gztproject/GO-button/PCB/GO-button/GO-button-QFN44.png

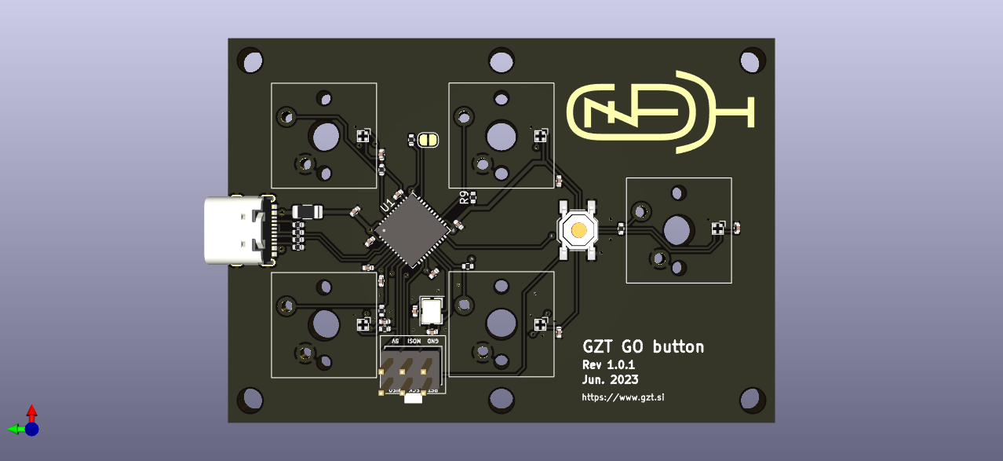
PCB/GO-button/GO-button-QFN44.png
