gztproject/GO-button/README.md

# GO-button



A programmable 5-button RGB macro keypad
