gztproject/GO-button/docs/index.rst

.. GZT-GO documentation master file, created by
   sphinx-quickstart on Mon Jan 22 09:24:08 2024.
   You can adapt this file completely to your liking, but it should at least
   contain the root `toctree` directive.

GZT-GO Button Documentation
==================================

.. toctree::
   :maxdepth: 3
   :caption: Contents:
   
   manual
   updating
   serialApi
   codelists
   changelog
