gztproject/GO-button/3D/v2/Go-Button-BoxTop_V2.3mf

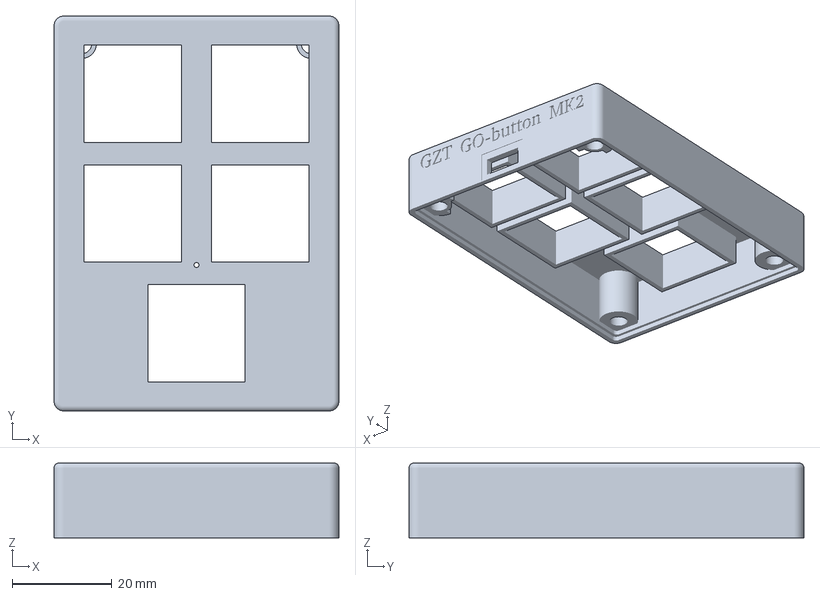
[picture p2: CAD file, 2026-03-15]
3D/v2/Go-Button-BoxTop_V2.3mf
57.0 x 79.0 x 15.0 mm
