gztproject/GO-button/3D/v2/Go-Button-DrillJigJig.3mf

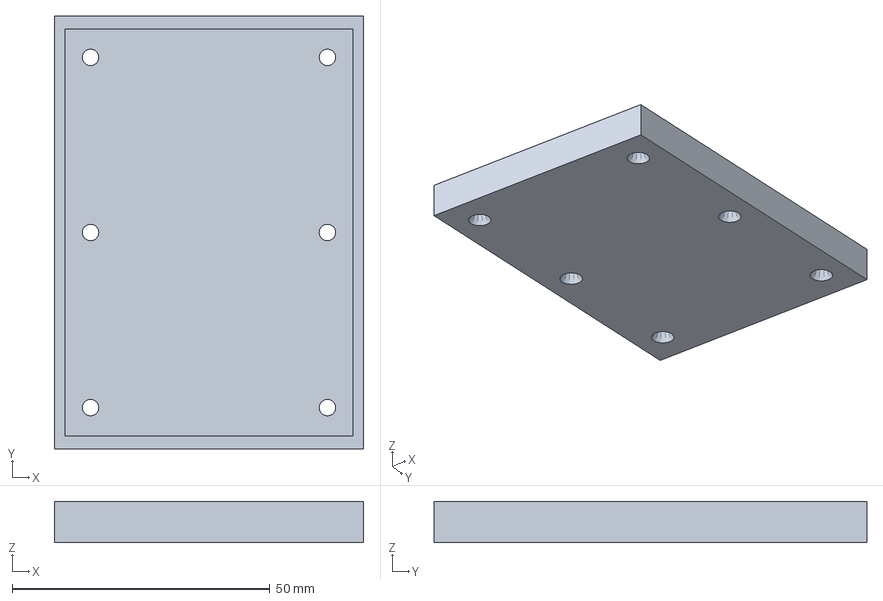
[picture p3: CAD file, 2026-03-15]
3D/v2/Go-Button-DrillJigJig.3mf
60.0 x 84.0 x 8.00 mm
