gztproject/GO-button/3D/v2/Go-Button-DrillJigCut001.3mf

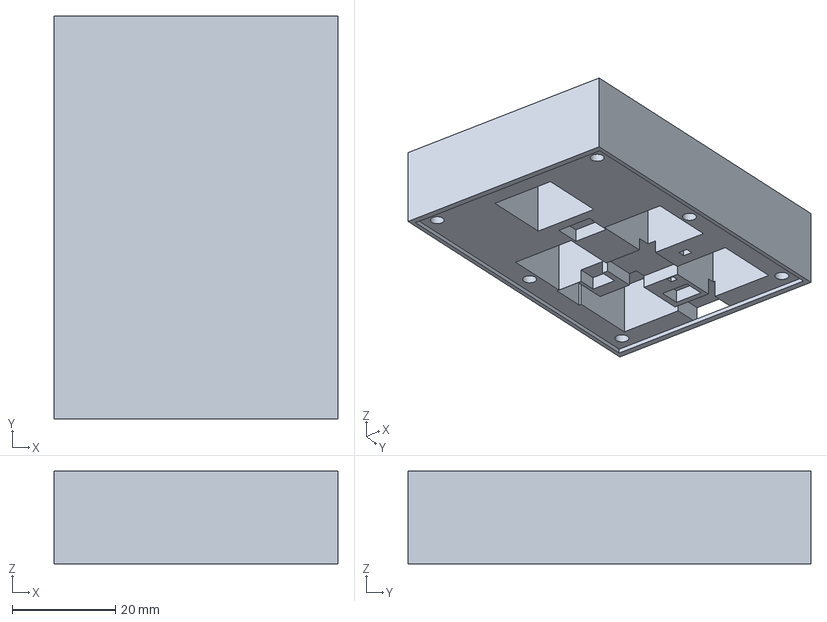
[picture p4: CAD file, 2026-03-15]
3D/v2/Go-Button-DrillJigCut001.3mf
55.0 x 78.0 x 18.0 mm
