gztproject/GO-button/3D/v2/Go-Button-BoxBottom_V2.3mf

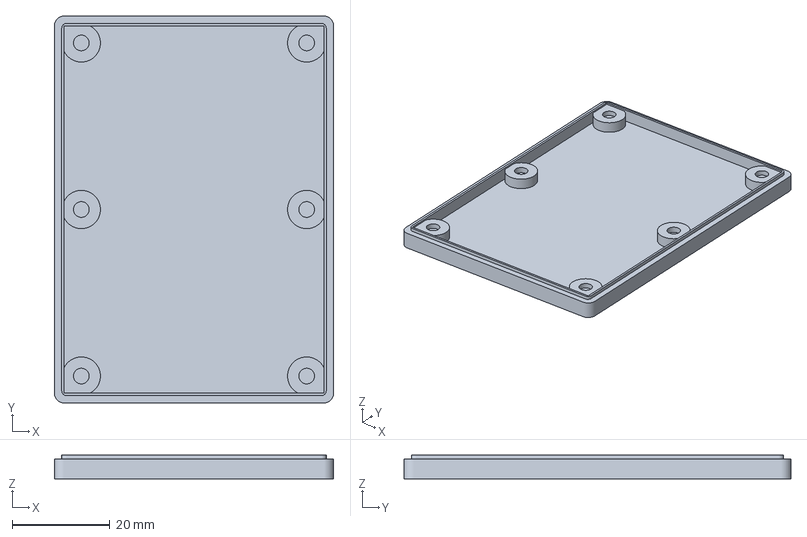
[picture p5: CAD file, 2026-03-15]
3D/v2/Go-Button-BoxBottom_V2.3mf
57.0 x 79.0 x 4.80 mm
