gztproject/GO-button/3D/v2/Go-Button-Box_V2.3mf

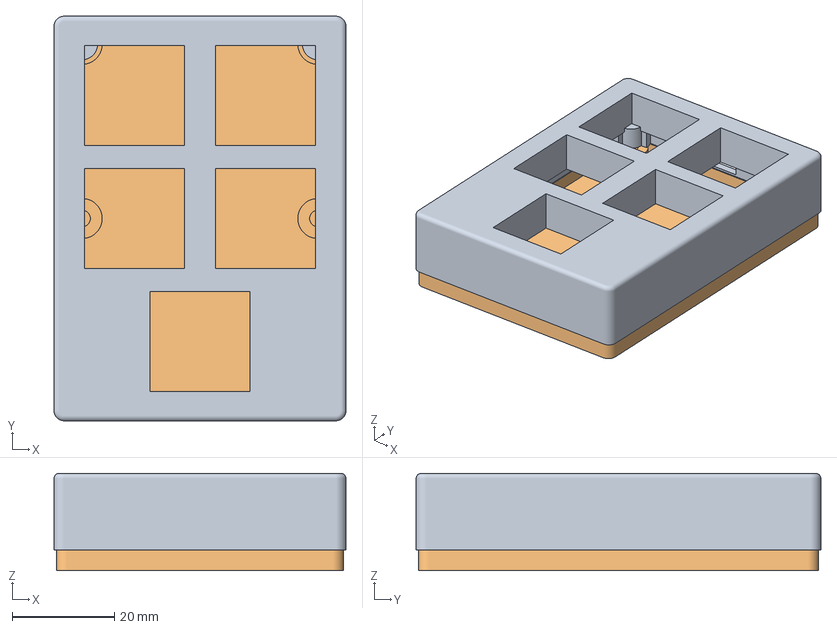
[picture p6: CAD file, 2026-03-15]
3D/v2/Go-Button-Box_V2.3mf
57.0 x 79.0 x 19.0 mm
