gztproject/GO-button/3D/v2/Go-Button-SolderingJig.stl

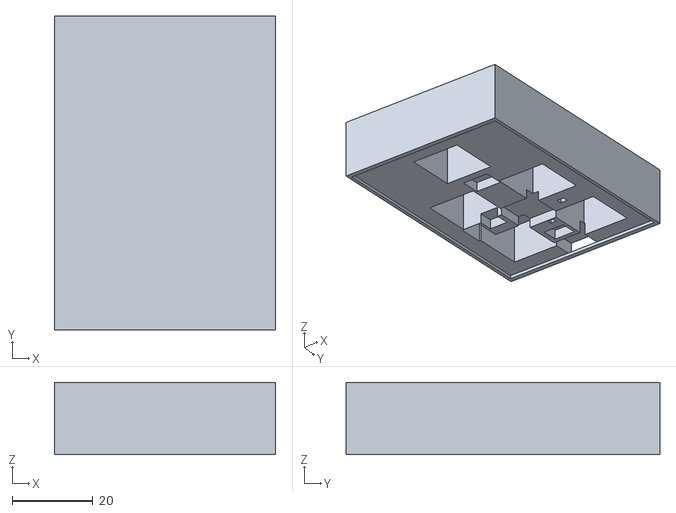
[picture p7: CAD file, 2024-02-04]
3D/v2/Go-Button-SolderingJig.stl
55.0 x 78.0 x 18.0
