gztproject/GO-button/3D/v2/DSA 1u.step

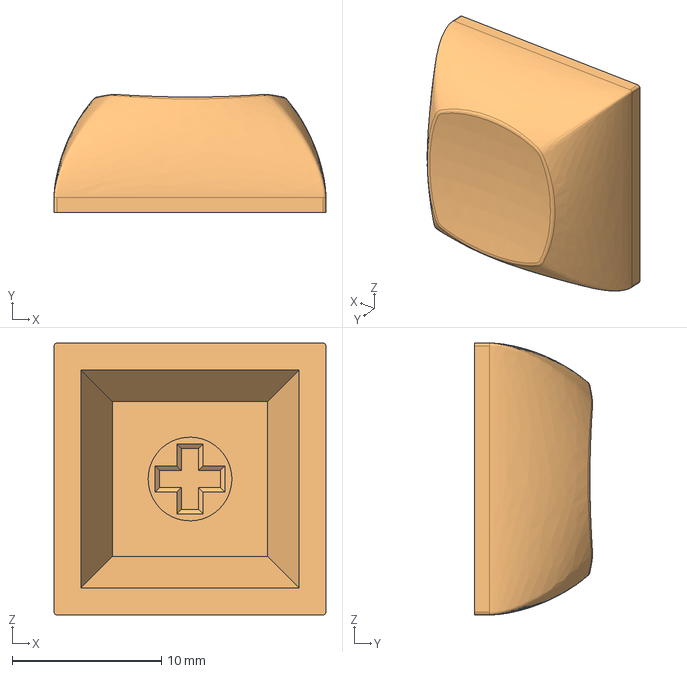
[picture p8: CAD file, 2023-05-16]
3D/v2/DSA 1u.step
18.2 x 7.91 x 18.2 mm
