gztproject/GO-button/3D/v1/Go-Button.FCStd

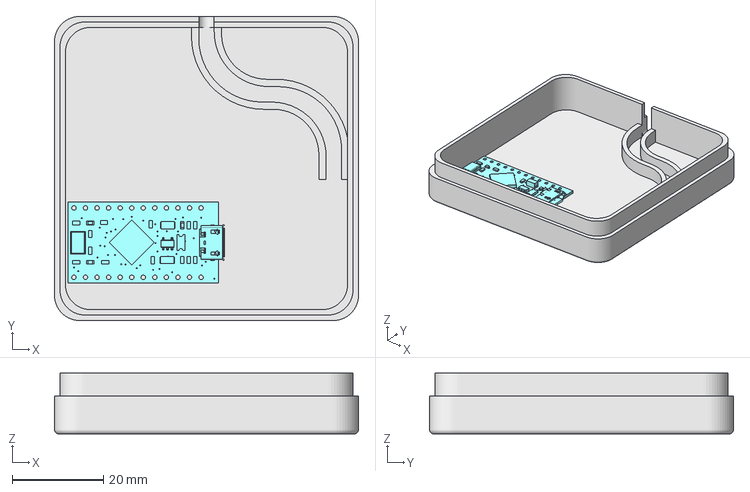
[picture p9: CAD file, 2023-05-16, an earlier design]
3D/v1/Go-Button.FCStd
66.8 x 66.8 x 13.4 mm
Pro_Micro
