gztproject/GO-button/3D/v1/Go-Button-Bottom.stl

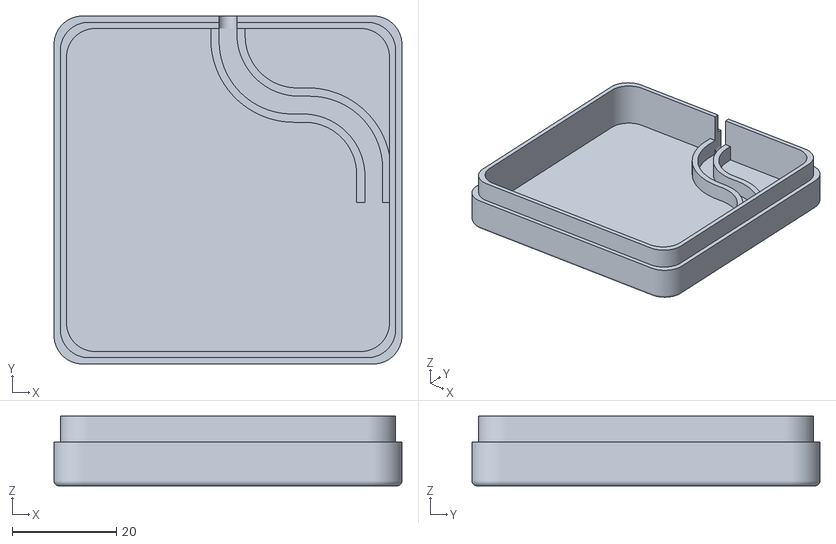
[picture p10: CAD file, 2023-05-16, an earlier design]
3D/v1/Go-Button-Bottom.stl
66.8 x 66.8 x 13.4
