gztproject/GO-button/3D/v1/Go-Button-Top.stl

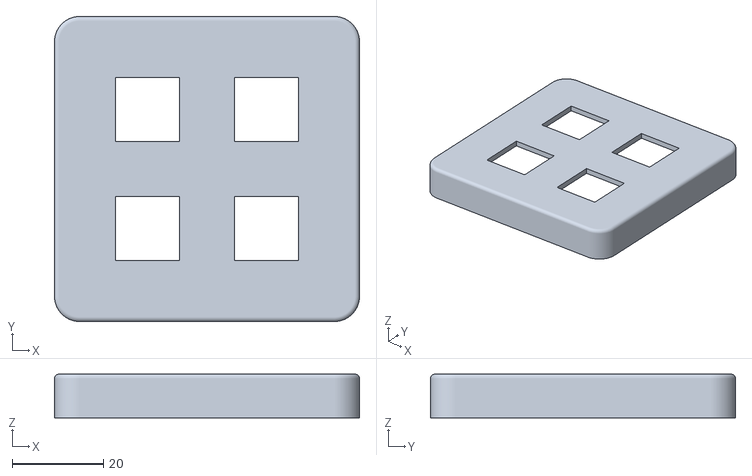
[picture p11: CAD file, 2023-05-16, an earlier design]
3D/v1/Go-Button-Top.stl
66.8 x 66.8 x 9.60
