gztproject/GO-button/3D/v2/Go-Button-BoxBottom.3mf

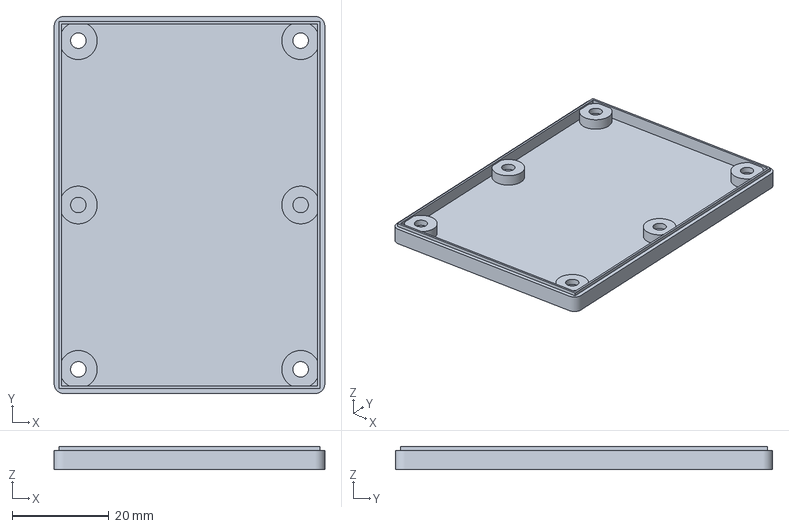
[picture p12: CAD file, 2023-05-16, an earlier design]
3D/v2/Go-Button-BoxBottom.3mf
56.0 x 78.0 x 4.80 mm
