gztproject/GO-button/3D/v2/Go-Button-BoxTop.3mf

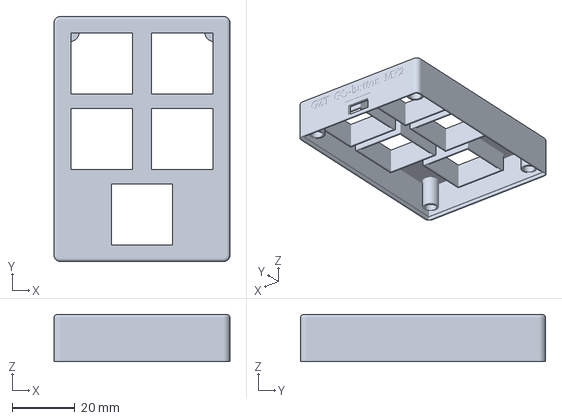
[picture p13: CAD file, 2023-05-16, an earlier design]
3D/v2/Go-Button-BoxTop.3mf
56.0 x 78.0 x 15.0 mm
