gztproject/GO-button/(list of files, cad)

Other CAD files:
3D/v2/Go-Button.FCStd
3D/v2/Go-Button-SolderingJigCut.amf
