gztproject/GO-button/docs/changelog.rst

.. _changelog:

#########################
Changelog
#########################

2.1.X
=========================

Migrating to this version requires factory resetting the device due to changes in data structure.

.. _V-2-1-1:

2.1.1 (2024-02-14)
---------------------------------------------------------------------------

:download:`firmware-2.1.1.hex <_static/firmware-2.1.1.hex>`

- Fixed default preset not being applied in the same restart

.. _V-2-1-0:

2.1.0 (2024-02-11)
---------------------------------------------------------------------------

:download:`firmware-2.1.0.hex <_static/firmware-2.1.0.hex>`

- Major code cleanup
- Serial API
- Separate reset and set default preset chords
- Added OFF preset
- Documentation

.. _V-2-0-0:

2.0.0 (2023)
=========================

- Settings saved in EEPROM
- C++ objects

.. _V-1-0-0:

1.0.0
=========================

- FIrst POC version
