gztproject/GO-button/PCB/GO-button/GO-button-QFN44.kicad_pcb

## KiCad design PCB/GO-button/GO-button-QFN44.kicad_pcb (2023-06-17)

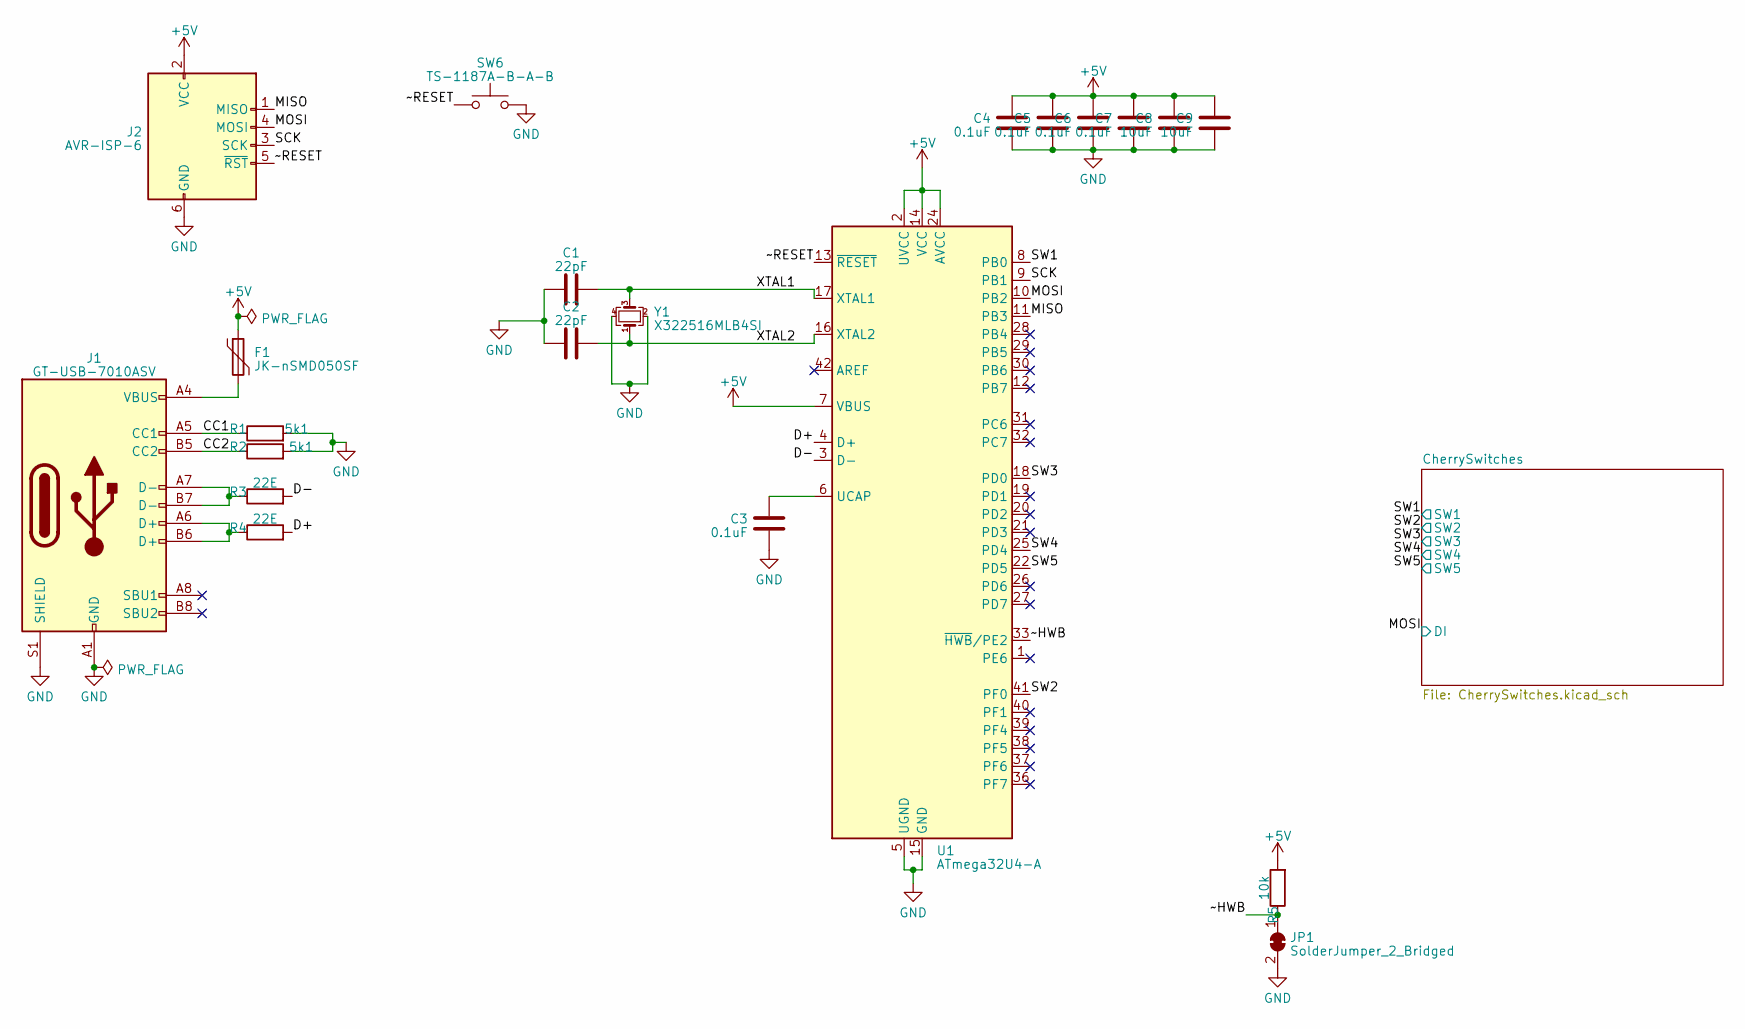
[picture p14: schematic GO-button-QFN44.kicad_sch, GO-button]

Parts:
C1, C2: 22pF; C_0402_1005Metric
C3, C4, C5, C6, C7: 0.1uF; C_0402_1005Metric
C8, C9: 10uF; C_0402_1005Metric
F1: JK-nSMD050SF; Fuse_1206_3216Metric
J1: GT-USB-7010ASV; USB_C_Receptacle_G-Switch_GT-USB-7010ASV
J2: AVR-ISP-6; AVR_ISP_HEADER
JP1: SolderJumper_2_Bridged; SolderJumper-2_P1.3mm_Bridged_RoundedPad1.0x1.5mm
R1, R2: 5k1; R_0402_1005Metric
R3, R4: 22E; R_0402_1005Metric
R5: 10k; R_0402_1005Metric
SW6: TS-1187A-B-A-B; SW_SPST_TL3342
U1: ATmega32U4-A; QFN-44-1EP_7x7mm_P0.5mm_EP5.2x5.2mm_ThermalVias
Y1: X322516MLB4SI; Crystal_SMD_3225-4Pin_3.2x2.5mm

Connections:
+5V: C4.2, C5.2, C6.2, C7.2, C8.2, C9.2, F1.1, J2.2 (VCC), R5.2, U1.2 (UVCC), U1.7 (VBUS), U1.14 (VCC), U1.24 (AVCC), U1.34 (VCC), U1.44 (AVCC); also elsewhere on the board
/CC1: J1.A5 (CC1), R1.1
/CC2: J1.B5 (CC2), R2.1
/D+: R4.2, U1.4 (D+)
/D-: R3.2, U1.3 (D-)
/MISO: J2.1 (MISO), U1.11 (PB3)
/MOSI: J2.4 (MOSI), U1.10 (PB2); also elsewhere on the board
/SCK: J2.3 (SCK), U1.9 (PB1)
/SW1: U1.8 (PB0); also elsewhere on the board
/SW2: U1.41 (PF0); also elsewhere on the board
/SW3: U1.18 (PD0); also elsewhere on the board
/SW4: U1.25 (PD4); also elsewhere on the board
/SW5: U1.22 (PD5); also elsewhere on the board
/XTAL1: C1.2, U1.17 (XTAL1), Y1.3
/XTAL2: C2.2, U1.16 (XTAL2), Y1.1
/~HWB: JP1.1 (A), R5.1, U1.33 (~HWB/PE2)
/~RESET: J2.5 (~RST), SW6.1, U1.13 (~RESET)
GND: C1.1, C2.1, C3.1, C4.1, C5.1, C6.1, C7.1, C8.1, C9.1, J1.A1 (GND), J1.A12 (GND), J1.B1 (GND), J1.B12 (GND), J1.S1 (SHIELD), J2.6 (GND), JP1.2 (B), R1.2, R2.2, SW6.2, U1.5 (UGND), U1.15 (GND), U1.23 (GND), U1.35 (GND), U1.43 (GND), Y1.2, Y1.4; also elsewhere on the board
unnamed: F1.2, J1.A4 (VBUS), J1.A9 (VBUS), J1.B4 (VBUS), J1.B9 (VBUS)
unnamed: J1.A6 (D+), J1.B6 (D+), R4.1
unnamed: J1.A7 (D-), J1.B7 (D-), R3.1
unnamed: C3.2, U1.6 (UCAP)

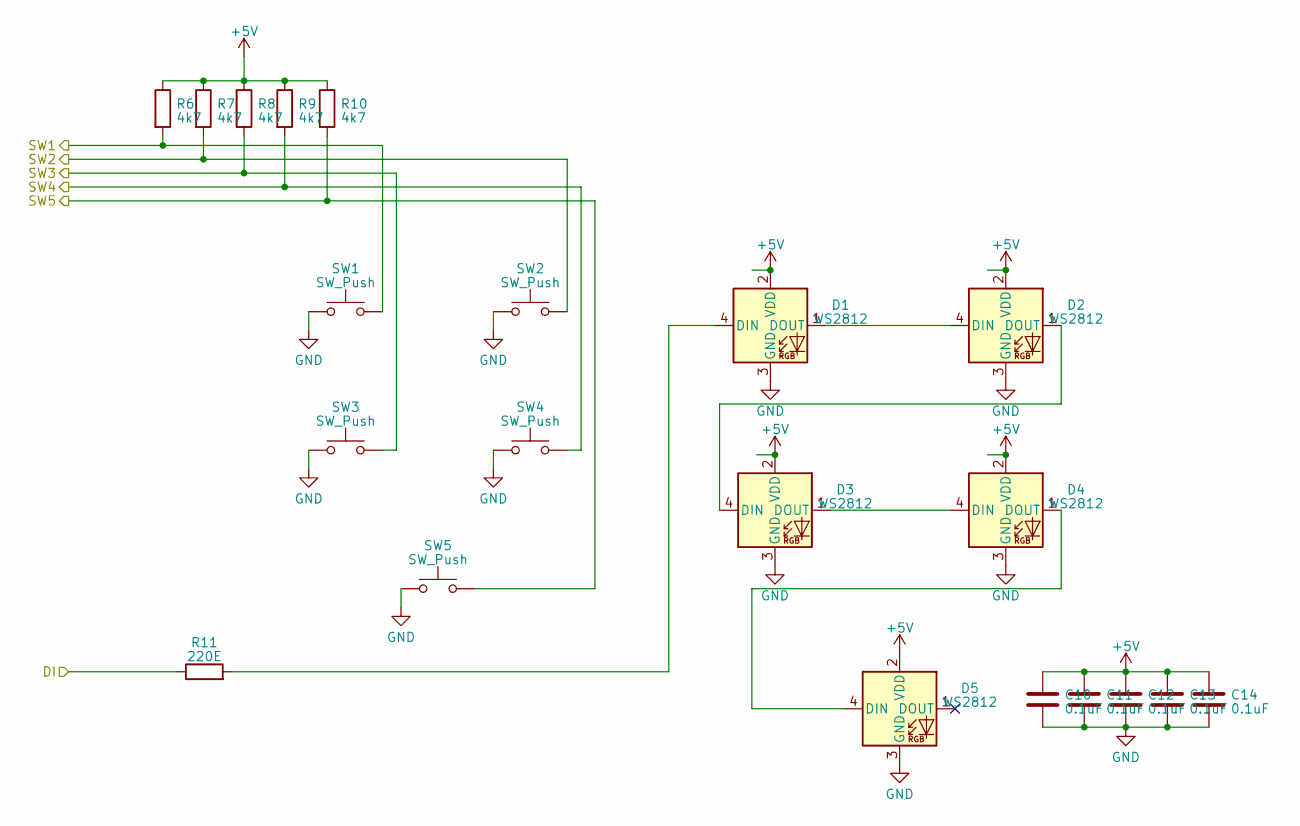
[picture p15: schematic CherrySwitches.kicad_sch]

Parts:
C10, C11, C12, C13, C14: 0.1uF; C_0402_1005Metric
D1, D2, D3, D4, D5: WS2812; XL-1010RGBC-WS2812B
R6, R7, R8, R9, R10: 4k7; R_0402_1005Metric
R11: 220E; R_0402_1005Metric
SW1, SW2, SW3, SW4, SW5: SW_Push; SW_Cherry_MX_PCB

Connections:
+5V: C10.1, C11.1, C12.1, C13.1, C14.1, D1.2 (VDD), D2.2 (VDD), D3.2 (VDD), D4.2 (VDD), D5.2 (VDD), R6.1, R7.1, R8.1, R9.1, R10.1; also elsewhere on the board
/MOSI: R11.1; also elsewhere on the board
/SW1: R6.2, SW1.2; also elsewhere on the board
/SW2: R7.2, SW2.2; also elsewhere on the board
/SW3: R8.2, SW3.2; also elsewhere on the board
/SW4: R9.2, SW4.2; also elsewhere on the board
/SW5: R10.2, SW5.2; also elsewhere on the board
GND: C10.2, C11.2, C12.2, C13.2, C14.2, D1.3 (GND), D2.3 (GND), D3.3 (GND), D4.3 (GND), D5.3 (GND), SW1.1, SW2.1, SW3.1, SW4.1, SW5.1; also elsewhere on the board
unnamed: D1.4 (DIN), R11.2
unnamed: D1.1 (DOUT), D2.4 (DIN)
unnamed: D2.1 (DOUT), D3.4 (DIN)
unnamed: D3.1 (DOUT), D4.4 (DIN)
unnamed: D4.1 (DOUT), D5.4 (DIN)

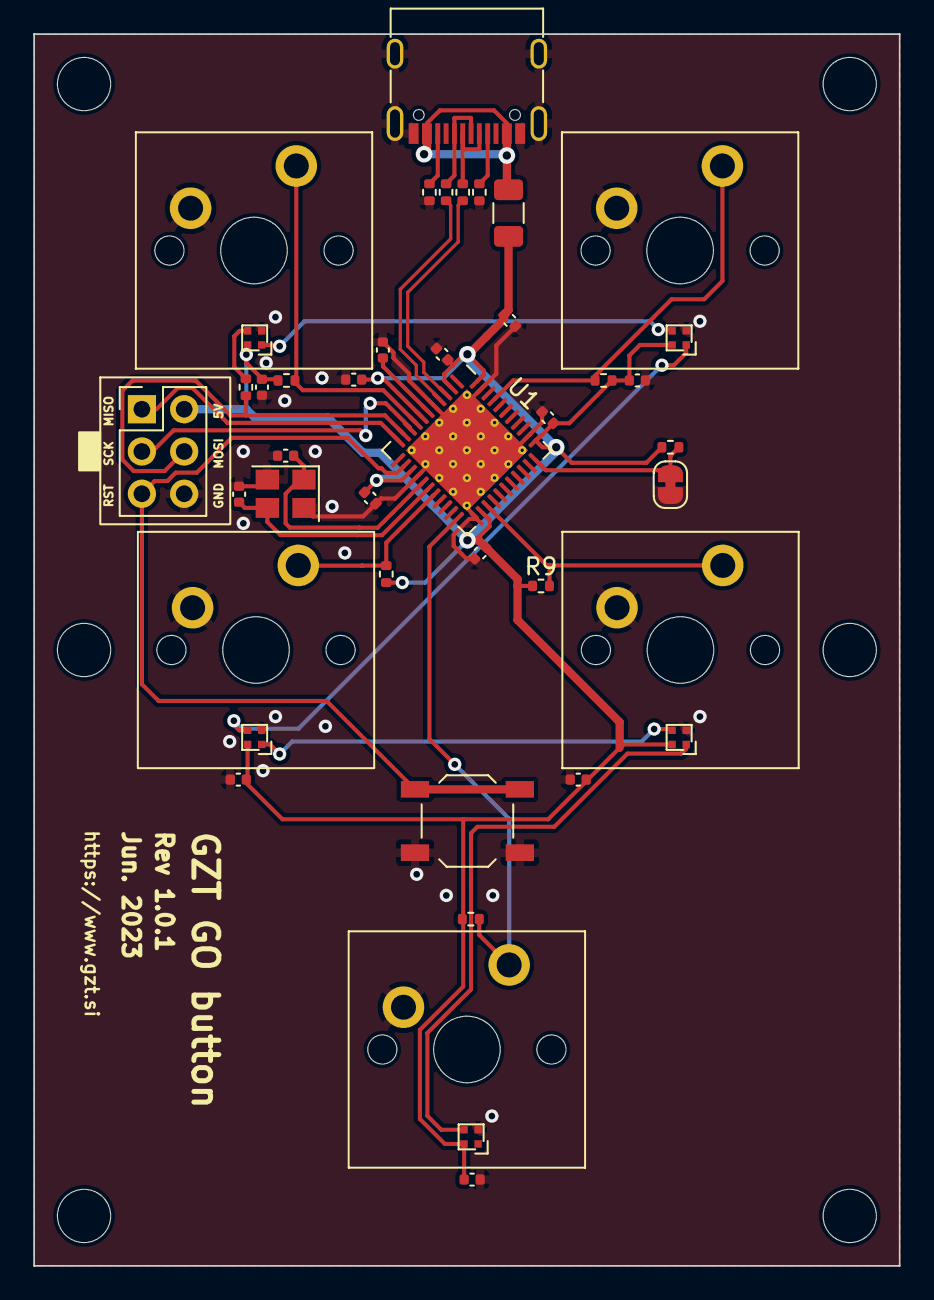
[picture p16: board GO-button-QFN44.kicad_pcb from above]

Board: 2 copper layers, 52.0 x 74.0 mm, 42 parts (0 on the bottom side), 27 nets.
