gztproject/GO-button/src/Keypad/Button.cpp

/**
 * @file Button.cpp
 * @author Gašper Doljak (info@gzt.si)
 * @brief All the button logic and variables
 * @version 2.0.1
 * @date 2023-06-21
 *
 *
 */
#ifndef BUTTON_C
#define BUTTON_C
#include "Button.h"

Button::Button()
{
    id = 0xFF;
    btnPin = 0;
    baseColor = BLACK;
    baseIntensity = 0;
    accentColor = BLACK;
    accentIntensity = 0;
    ledColorState = BLACK;
    callback = {};

    pinMode(btnPin, INPUT_PULLUP);
}

Button::Button(uint8_t _id, uint8_t pin, RgbColor col, uint8_t ledInt, void (*_callback)(uint8_t i, KeyActions action))
{
    id = _id;
    btnPin = pin;
    baseColor = col;
    baseIntensity = ledInt;
    accentColor = col;
    accentIntensity = ledInt;
    ledColorState = BLACK;
    callback = _callback;

    pinMode(btnPin, INPUT_PULLUP);

    LedOff();
}

Button::Button(uint8_t _id, uint8_t pin, RgbColor bCol, uint8_t bInt, RgbColor aCol, uint8_t aInt, void (*_callback)(uint8_t i, KeyActions action))
{
    id = _id;
    btnPin = pin;
    baseColor = bCol;
    baseIntensity = bInt;
    accentColor = aCol;
    accentIntensity = aInt;
    ledColorState = BLACK;
    callback = _callback;

    pinMode(btnPin, INPUT_PULLUP);

    LedOff();
}

void Button::SetCallback(void (*_callback)(uint8_t i, KeyActions action))
{
    callback = _callback;
}

void Button::Tick()
{
    unsigned long time = millis();
    bool newState = (digitalRead(btnPin) == LOW);

    // Button state changed for enough time (DEBOUNCE_TIME)
    if (oldState != newState && (time - lastChangeMillis > DEBOUNCE_TIME))
    {
        oldState = newState;
        lastChangeMillis = time;
        // Serial.print("Keypress: ");
        if (newState)
        {
            // Serial.println("ON");
            LedAccent();
            callback(id, KeyActions::ON);
        }
        else
        {
            // Serial.println("OFF");
            if ((ledIntensityState > baseIntensity) && flashingSpeed == 0)
                LedBase();
            callback(id, KeyActions::OFF);
        }
    }

    // LED flashing stuff
    if (flashingSpeed != 0 && (time - lastFlash > flashingSpeed))
    {
        // If we flashed out our count or it's indefinite turn flashing off.
        if (flashes != 0 && flashCount >= flashes)
        {
            // Serial.println("Flashing off.");
            FlashOff();
        }
        else
        {
            if (ledIntensityState > baseIntensity)
            {
                // Serial.println("Flashing --");
                LedBase();
            }
            else
            {
                // Serial.println("Flashing ++");
                LedAccent();
                flashCount++;
            }
            lastFlash = time;
        }
    }
}

void Button::LedOn(RgbColor color, uint8_t intensity)
{
    ledColorState = color.Dim(intensity);
    ledIntensityState = intensity;
}

void Button::LedBase()
{
    LedOn(baseColor, baseIntensity);
}

void Button::LedAccent()
{
    LedOn(accentColor, accentIntensity);
}

void Button::FlashOff()
{
    flashingSpeed = 0;
    LedDimm();
}

void Button::LedOff()
{
    ledIntensityState = 0;
    ledColorState = BLACK;
}

void Button::SetBaseColor(RgbColor col, uint8_t intensity)
{
    baseColor = col;
    baseIntensity = intensity;
    if (ledIntensityState > 0 && ledIntensityState < accentIntensity)
    {
        LedBase();
    }
}

void Button::SetAccentColor(RgbColor col, uint8_t intensity)
{
    accentColor = col;
    accentIntensity = intensity;
    if (ledIntensityState > baseIntensity)
    {
        LedAccent();
    }
}

void Button::Flash(uint8_t number, uint16_t speed, uint8_t intensity)
{
    flashes = number;
    flashCount = 0;
    flashingSpeed = speed;
    flashIntensity = intensity;
    lastFlash = millis();
}

#endif
