gztproject/GO-button/(commit log)

2021-10-02 Extracted button in a separate class
2023-05-16 Updated PCB, switched libraries, code fixes
    [CherrySwitches.kicad_sch, DSA 1u.step, GO-button-QFN44.kicad_pcb, GO-button-QFN44.kicad_sch, GO-button.kicad_pcb, GO-button.kicad_sch, Go-Button-Bottom.stl, Go-Button-BoxBottom.3mf]
2023-05-18 LED bugfix
2023-06-17 PCB REV 1.0.1
    [GO-button-QFN44.kicad_pcb, bom.csv, designators.csv, positions.csv]
2023-06-18 Removed settings, shorter buffers
    [Keypad.cpp, main.cpp]
2023-06-20 Added board def to the project
2023-06-20 Fixed the custom bord variant
    [pins_arduino.h]
2024-02-04 Added soldering jig
    [Go-Button-SolderingJig.stl, Go-Button-SolderingJigCut.amf]
2024-02-11 Major code cleanup, fixes, lots of docs...
    [Keypad.cpp, Keypad.h, Preset.h, SerialAPI.cpp, SerialAPI.h, config.h, main.cpp]
2024-02-14 SetDefault fix, added changelog
    [Keypad.cpp]
2026-03-15 3D files
    [Go-Button-BoxBottom_V2.3mf, Go-Button-BoxTop_V2.3mf, Go-Button-Box_V2.3mf, Go-Button-DrillJigCut001.3mf, Go-Button-DrillJigJig.3mf, Go-Button.FCStd]
